GianMarcosBoaretto/moinho-mqtt/GUIA.md

# Guia de uso e de teste

Passo a passo para rodar o protótipo, usar o dashboard e testar cada requisito da entrega.
Também mostra como usar um **celular como nó transmissor** (seção 10) e o **painel de
tráfego** do dashboard, que mostra cada requisição e mensagem (seção 11).
Para o porquê das decisões, veja o [README](README.md) e a pasta [docs/](docs/).

## 1. O que você precisa

Escolha **um** dos dois jeitos:

| Jeito | Precisa de | Quando usar |
|---|---|---|
| **A. Docker** | Docker Desktop | é o jeito oficial da entrega; usa o Mosquitto de verdade e roda o teste automatizado |
| **B. Sem Docker (Windows)** | só Python 3.12 | máquina sem Docker; usa um broker MQTT em Python no lugar do Mosquitto |

Todos os comandos abaixo rodam na pasta do projeto (`moinho-mqtt`).

## 2. Como rodar

### Jeito A — Docker

Na primeira vez, crie o arquivo de senhas (`.env`, que não vai para o Git):

```bash
python scripts/preparar_segredos.py
```

Depois:

```bash
docker compose up --build
```

Espere aparecer `[MQTT] conectado ao broker` nos logs e abra <http://localhost:8085>.
Para parar: `Ctrl+C`, ou `docker compose down` em outro terminal.

### Jeito B — sem Docker (Windows)

```powershell
powershell -ExecutionPolicy Bypass -File scripts\rodar-local.ps1
```

Na primeira vez ele cria o ambiente Python (`.venv`) e instala as dependências, o que
leva cerca de 1 minuto. Depois abre **três janelas** e o navegador no dashboard:

| Janela | O que é | O que aparece nela |
|---|---|---|
| `BROKER MQTT` | o "correio" das mensagens | conexões dos clientes |
| `BACKEND` | o supervisório (recebe, grava, serve o dashboard) | `[RX]` a cada leitura recebida |
| `SIMULADOR` | o nó de medição (faz o papel do ESP32) | `[PROTECAO]`, `[MQTT]`, `[BUFFER]` |

Para parar tudo, feche as três janelas.

## 3. Usando o dashboard

Abra <http://localhost:8085>. A tela atualiza sozinha a cada 1 segundo.

| Parte da tela | O que mostra |
|---|---|
| Topo, à direita | `broker: conectado · nó: online` — situação da comunicação |
| **Corrente** | último valor medido, com "medido às HH:MM:SS" e o atraso de entrega (skew) |
| **Estado do nó** | `OPERANDO` (verde), `DESARMADO` ou `EMERGENCIA` (vermelho), com o motivo |
| **Último alarme** | último desarme/rearme e a hora em que aconteceu |
| **Consistência** | leituras gravadas, duplicadas descartadas, inválidas e lacunas de `seq` |
| **Gráfico** | últimos 3 min: azul = tempo real, laranja = chegou atrasado do buffer, tracejado = limite de 100 A |
| **Eventos** | desarmes, rearmes, emergências e nó online/offline |

Quando a comunicação cai, aparece um **banner vermelho** no topo. Nesse momento a corrente
e o estado ficam **em cinza**, com "VALOR ANTIGO" ao lado, e o gráfico ganha uma faixa
"sem dados".

## 4. Comandando o simulador

O simulador aceita comandos que imitam o que aconteceria na bancada:

| Comando | Imita | O que deve acontecer |
|---|---|---|
| `sobrecorrente` | carga pesada no moinho (~128 A) | em ~0,3 s: **DESARMADO**, motivo sobrecorrente, corrente cai para ~0 |
| `normal` | carga volta ao normal (~72 A) | nada visível: o desarme fica **travado** até rearmar |
| `rearmar` | botão de rearme | volta a **OPERANDO**; se a causa ainda existir (carga alta, sensor em falha), o rearme é **recusado** |
| `emergencia` | apertar a botoeira | **EMERGENCIA**, motor para |
| `liberar` | soltar a botoeira | sai da emergência; se havia desarme, continua desarmado |
| `falha_sensor` | sensor rompido | **DESARMADO**, motivo falha de sensor; a corrente aparece como "falha" |

Como enviar:

- **Jeito A (Docker):**
  ```bash
  ./scripts/comando.sh sobrecorrente
  ```
- **Jeito B (sem Docker):**
  ```powershell
  powershell -ExecutionPolicy Bypass -File scripts\comando.ps1 sobrecorrente
  ```

O comando chega ao simulador por um arquivo, **sem passar pelo MQTT**. Por isso
funciona também com o broker fora do ar, que é justamente o teste mais importante.

Para voltar ao estado inicial depois de um teste, envie `normal`, `liberar` e `rearmar`.

## 5. Como ver que está transmitindo

São três lugares, um para cada etapa do caminho:

1. **No broker — a mensagem está passando.** Em outro terminal:
   ```powershell
   .\.venv\Scripts\python scripts\espiar.py
   ```
   Deve aparecer uma mensagem `fabrica/planta1/moinho01/corrente` por segundo, com o
   `seq` subindo de 1 em 1. O status `[retained]` aparece logo ao conectar.
   (No Docker: `docker exec moinho-broker mosquitto_sub -t 'fabrica/#' -v`.)
2. **No backend — foi recebida e gravada.** A janela `BACKEND` (ou
   `docker compose logs -f backend`) mostra:
   ```
   [RX] moinho01 seq=4000000015 77.1 A operando skew=1 ms (tempo real)
   ```
3. **No dashboard — foi usada.** "medido às" avança a cada segundo, "gravadas" sobe e o
   gráfico azul cresce para a direita.

A API também pode ser aberta direto no navegador:
<http://localhost:8085/api/estado> ·
<http://localhost:8085/api/historico> ·
<http://localhost:8085/api/eventos>.

## 6. Roteiro de teste manual

Faça na ordem. Cada teste diz o que fazer e o que tem que aparecer. Se aparecer, passou.

### T1 — Fluxo normal

| Faça | Resultado esperado |
|---|---|
| Suba o sistema e espere 10 s | dashboard com ~72 A, **OPERANDO**, topo "broker: conectado · nó: online", sem banner |
| Rode o `espiar.py` | uma mensagem `/corrente` por segundo, `seq` sequencial |

### T2 — Proteção com rede funcionando

| Faça | Resultado esperado |
|---|---|
| Envie `sobrecorrente` | **DESARMADO**, motivo sobrecorrente; corrente ~0 A; "Desarme" na tabela de eventos; pico acima da linha de 100 A no gráfico |
| Envie `rearmar` (sem enviar `normal` antes) | rearme **recusado**: continua DESARMADO, e o log do simulador diz "a causa do desarme continua" (igual à bancada, que não rearma com a corrente alta) |
| Envie `normal` e depois `rearmar` | **OPERANDO**, ~72 A, evento "Rearme" |

### T3 — Emergência e falha de sensor

| Faça | Resultado esperado |
|---|---|
| Envie `emergencia` | **EMERGENCIA**, corrente ~0 |
| Envie `rearmar` | **recusado**: o log do simulador diz "rearme recusado: botoeira pressionada" |
| Envie `liberar` e depois `rearmar` | volta a **OPERANDO** |
| Envie `falha_sensor` | **DESARMADO**, motivo falha de sensor, corrente "falha" |
| Envie `normal` e depois `rearmar` | volta a **OPERANDO** |

### T4 — Queda de comunicação (o teste principal)

| Faça | Resultado esperado |
|---|---|
| **Derrube o broker.** Jeito B: feche a janela `BROKER MQTT`. Jeito A: `docker stop moinho-broker` | log do simulador: "broker inacessivel ... A PROTECAO LOCAL CONTINUA ATUANDO" |
| Espere 6 s | **banner vermelho** "Comunicação perdida há Xs — último dado recebido às HH:MM:SS"; valores **em cinza** com "VALOR ANTIGO"; topo "broker: DESCONECTADO"; faixa "sem dados" no gráfico |
| Com o broker ainda fora, envie `sobrecorrente` | **o simulador desarma mesmo sem rede**. O log mostra `estado=desarmado motivo=sobrecorrente ... (decidido localmente, SEM REDE)`. O dashboard **ainda mostra OPERANDO em cinza**, porque o dado não chegou, e o banner avisa disso |
| Espere 15 s | o log do simulador repete a cada 5 s: "sem broker ha Xs - protecao local ATIVA ... buffer N/300" |

### T5 — Volta da comunicação e reconstrução do histórico

| Faça | Resultado esperado |
|---|---|
| **Religue o broker.** Jeito B: `powershell -ExecutionPolicy Bypass -File scripts\rodar-local.ps1 -SoBroker`. Jeito A: `docker start moinho-broker` | log do simulador: "conectado ao broker (ficou fora Xs); buffer com N mensagens" e "[BUFFER] flush: N mensagens reenviadas" |
| Olhe o dashboard | banner some; **DESARMADO / sobrecorrente**; o trecho da falha aparece **em laranja** no gráfico; o desarme está nos eventos com a **hora em que aconteceu** (durante a falha), e não com a hora em que chegou; "lacunas de seq: 0" |
| Olhe a janela `BACKEND` | linhas `[RX] ... skew=12000 ms (BUFFER)` e depois `[RECUPERADO] ... lacunas restantes: 0` |
| Envie `normal` e `rearmar` | volta a **OPERANDO** |

### T6 — Duplicados são descartados

O reenvio do buffer normalmente não gera duplicado. Para provar que o backend descarta,
reenvie de propósito uma leitura que já foi gravada:

- **Jeito A:** o `teste_falha.sh` faz isso sozinho na etapa 5 (ver a seção 7).
- **Jeito B:**
  ```powershell
  .\.venv\Scripts\python -c "import json,urllib.request as u,paho.mqtt.publish as p; l=json.load(u.urlopen('http://localhost:8085/api/historico'))[-3]; m=json.dumps(dict(schema=1,device_id='moinho01',**{k:l[k] for k in ('seq','ts_origem','corrente_a','estado','motivo')})); [p.single('fabrica/planta1/moinho01/corrente',m,qos=1) for _ in range(2)]; print('reenviado seq',l['seq'])"
  ```

**Resultado esperado:** a janela `BACKEND` mostra duas linhas
`[DUP] moinho01 seq=... ja gravado -> descartado`, e no dashboard "duplicadas
descartadas" sobe 2. O histórico **não** ganha ponto novo.

### T7 — Buffer cheio (opcional, demora 5 min)

| Faça | Resultado esperado |
|---|---|
| Derrube o broker e espere **mais de 5 min** | log do simulador: "[BUFFER] cheio (300): descartando a mais antiga seq=..." |
| Religue o broker | dashboard mostra "lacunas de seq: 1 (N amostras)": o que passou de 5 min se perdeu, e o sistema **avisa** em vez de esconder |

## 7. Teste automatizado

Sem Docker (Windows), com o `rodar-local` fechado:

```powershell
powershell -ExecutionPolicy Bypass -File scripts\teste_falha_local.ps1
```

Ele sobe tudo sozinho em segundo plano, com banco próprio, executa T1, T4, T5 e T6 e
grava o resultado em `logs\local-<data-hora>\resultado.txt`. Leva cerca de 1 minuto.

Com Docker:

```bash
./scripts/teste_falha.sh
```

Ele executa T1, T4, T5 e T6 sozinho, em cerca de 1 min 30 s. Com o dashboard aberto ao
lado, tire um print a cada `>>> PRINT:` que aparecer no terminal. No final ele mostra
`RESULTADO: todas as verificacoes passaram` e salva logs e JSON em `logs/<data-hora>/`.
O que cada print precisa mostrar está em [EVIDENCIAS.md](EVIDENCIAS.md).

## 8. Com o ESP32 de verdade

A montagem segue o material da aula em `docs/bancada/` (diagrama de ligação, diagrama do relé
e passo a passo). Primeiro monte e teste com o código da **fase 1**,
`firmware/g2_moinho_teste/g2_moinho_teste.ino`, que não usa rede. Depois grave o firmware do grupo:

1. Na Arduino IDE, instale as bibliotecas **MQTT** (Joel Gaehwiler) e **ArduinoJson**.
2. Ligue o jumper do **GPIO27 ao GND**. Sem ele, o firmware entende que a emergência está
   apertada e mantém o motor parado.
3. Em `firmware/moinho01/`, ajuste o `config.h`: nome da rede Wi-Fi e `MQTT_HOST` com o
   **IP do PC** (`ipconfig`). Copie `secrets.exemplo.h` para `secrets.h` e preencha a senha do
   Wi-Fi e a `MQTT_SENHA` (o valor de `MQTT_SENHA_NO` no `.env` do PC).
4. No PC, suba sem o simulador, que usa o mesmo nome do ESP32:
   ```powershell
   powershell -ExecutionPolicy Bypass -File scripts\rodar-local.ps1 -SemSimulador
   ```
5. Grave na placa (*ESP32 Dev Module*) e abra o Monitor Serial em 115200.
6. Os testes são os mesmos da seção 6, trocando os comandos pela bancada:

| Comando do simulador | Na bancada | LEDs |
|---|---|---|
| `sobrecorrente` | girar o potenciômetro acima de ~2/3 do curso (> 100 A) | vermelho |
| `normal` | voltar o potenciômetro | continua vermelho até rearmar |
| `rearmar` | apertar o rearme (GPIO 14) por meio segundo, **com a corrente baixa** | verde |
| `emergencia` / `liberar` | tirar / recolocar o jumper do GPIO27 | vermelho / volta ao estado anterior |
| `falha_sensor` | girar o potenciômetro até o fim do curso (leitura saturada) | vermelho |
| derrubar o broker | fechar a janela do broker, ou desligar o Wi-Fi | não mudam: a proteção é local |

No T4, a prova mais forte: com o broker desligado, gire o potenciômetro. **O relé tem que
abrir**, o LED vermelho acende e o Monitor Serial mostra "SEM REDE". O ESP32 só conecta em
rede 2,4 GHz sem página de login; o mais simples é rotear a internet do celular.

> No PC, o Firewall do Windows pode bloquear a porta 1883 para a placa. Se o ESP32 não
> conectar, libere a porta 1883 (TCP) na rede privada.

## 9. Problemas comuns

| Sintoma | Causa provável | O que fazer |
|---|---|---|
| Dashboard abre mas fica "Nenhum dado recebido do nó ainda" | simulador não está rodando ou não achou o broker | veja a janela `SIMULADOR`; se diz "conectando" sem "conectado", o broker está fora |
| Simulador conecta e desconecta a cada ~3 s | **dois simuladores** abertos com o mesmo `client_id` (o broker derruba o mais antigo) | feche as janelas repetidas e deixe um só |
| `error while attempting to bind on address ... 8085` | já tem um backend rodando na porta 8085 | feche a janela `BACKEND` antiga |
| `rodar-local.ps1 não pode ser carregado ... execução de scripts desabilitada` | política de execução do Windows | rode com `powershell -ExecutionPolicy Bypass -File ...`, como neste guia |
| Banner fica vermelho com o broker no ar | relógio do PC errado, ou o backend não reconectou | confira `broker` no topo do dashboard; se estiver "DESCONECTADO", reinicie o backend |
| Quero recomeçar do zero | — | feche tudo e apague `backend/moinho.db` e a pasta `simulador/estado/`. No Docker: `docker compose down -v` |
| Celular não abre a página `/celular` | celular em outra rede, ou firewall bloqueando a porta 8085 | confira se o celular está no **mesmo Wi-Fi** do PC; libere o Python (ou a porta 8085 TCP) no Firewall do Windows |
| Celular abre a página mas para de transmitir | tela apagou: o navegador do celular congela a página em segundo plano | deixe a tela ligada e o navegador em primeiro plano durante a demonstração |

## 10. Celular como nó transmissor

Um celular pode fazer o papel do ESP32. A página `/celular` roda **no navegador do
celular** a mesma lógica do nó: proteção local a cada 100 ms, buffer circular de 300 e o
mesmo payload. O celular **é o moinho01**: faz o papel do simulador. Por isso o
simulador do PC precisa estar **desligado**; se os dois publicarem como `moinho01`, a
página do celular mostra um aviso vermelho.

### Como abrir

1. PC e celular na **mesma rede Wi-Fi**.
2. Suba o sistema **sem o simulador**:
   - jeito B: `powershell -ExecutionPolicy Bypass -File scripts\rodar-local.ps1 -SemSimulador`
     (ele já escuta na rede);
   - jeito A: `docker compose up --build broker backend`.
3. No topo do dashboard aparece "📱 no celular, abra **http://IP-DO-PC:8085/celular**".
   Digite esse endereço no navegador do celular. Na primeira vez ele pede a **chave de
   acesso**: é o valor de `GATEWAY_TOKEN` no arquivo `.env` do PC. Sem ela, o PC recusa os
   envios (HTTP 401), e as leituras ficam guardadas no celular até a chave certa.
4. Abra `localhost:8085` no PC. O dashboard mostra o **moinho01**, que agora é o seu
   celular: mexa na carga no celular e veja a corrente mudar no PC. A faixa
   **Dispositivos**, no topo, mostra todos os dispositivos ao vivo; clique num deles para
   trocar.

### O caminho do dado

```
celular ──HTTP POST /api/gateway/corrente──▶ backend (ponte) ──MQTT QoS 1──▶ broker ──▶ assinante ──▶ SQLite ──▶ dashboard
   ▲                                              │
   └────── resposta 200 + GET /api/gateway/situacao ("o PC gravou até o seq X")
```

O navegador do celular não fala MQTT puro, só HTTP. Por isso o backend recebe a leitura
por HTTP e **publica no broker** no tópico `fabrica/planta1/moinho01/corrente`, igual a
um ESP32. Dali em diante o caminho é o mesmo do simulador. O celular **envia** a leitura e
**recebe** de volta a confirmação: a resposta do POST e, a cada 2 s, quantas leituras o PC
já gravou, o último `seq` e o atraso.

### O que dá para fazer na tela do celular

| Controle | Faz o papel de | Resultado |
|---|---|---|
| Controle deslizante "Carga do moinho" | potenciômetro | acima de 100 A por 0,3 s: **DESARMADO · sobrecorrente** |
| 🛑 Emergência | botoeira (liga/desliga) | **EMERGENCIA**, motor para |
| ↺ Rearmar | botão de rearme | volta a OPERANDO, se a causa sumiu e a emergência foi solta |
| ⚡ Falha de sensor | sensor rompido (liga/desliga) | **DESARMADO · falha de sensor** |
| 📵 Simular queda | cortar a comunicação | nada sai do celular; as leituras vão para o buffer |

O "Log de envio e resposta" mostra cada requisição: `→ POST corrente seq …0042 72.1 A ← 200 · 4 ms`.

### Teste de queda pelo celular

1. Toque **📵 Simular queda**. Em 5 s o dashboard mostra o banner de
   comunicação perdida.
2. Arraste a carga para **130 A**. O celular desarma **sozinho**, e o log diz "decidido no
   celular, SEM REDE". O contador "no buffer" sobe.
3. Volte a carga para ~72 A e toque **📵 Simular queda** de novo. O log mostra "flush do
   buffer: N mensagens reenviadas", e o celular exibe "PC confirmou: ... lacunas 0".
4. No dashboard, o desarme aparece nos eventos com a hora em que aconteceu no celular.
5. Toque **↺ Rearmar**.

Também vale desligar o Wi-Fi do celular de verdade. Com o Wi-Fi desligado a página
continua aberta e protegendo, e reenvia tudo quando a rede volta. Recarregar a página
apaga o buffer, porque ele fica na memória do navegador. As mensagens que estavam nele
viram lacuna de `seq`, e o dashboard mostra isso.

## 11. Painel de tráfego (o "Wireshark" do dashboard)

À direita do dashboard fica o painel **Tráfego**. Ele mostra, ao vivo, cada mensagem que
o backend enviou ou recebeu, com a mais nova em cima:

| Tipo | Exemplo | Significa |
|---|---|---|
| `HTTP` | `192.168.1.40 → backend :8085` · `POST /api/gateway/corrente -> 200 · 4 ms` | requisição que chegou na API: quem pediu (IP), o quê, status e tempo de resposta |
| `MQTT` ⇢ (TX) | `supervisorio-planta1 (ponte HTTP) ⇢ broker` · `PUBLISH fabrica/planta1/moinho01/corrente QoS1` | o backend publicou no broker (ponte do celular) |
| `MQTT` ⇠ (RX) | `moinho01 (via broker) ⇠ supervisorio-planta1` · `PUBLISH fabrica/planta1/moinho01/corrente QoS1` | mensagem que o broker entregou ao assinante |
| `MQTT` ⇄ | `CONNECT ok` / `conexao PERDIDA` | o backend conectou ou perdeu o broker |

- **Clique numa linha** para abrir o conteúdo: payload JSON, tópico, QoS, retained,
  corpo enviado e resposta do HTTP, IP e navegador de quem chamou.
- Uma **barra laranja à esquerda** marca o que veio do celular.
- Uma **linha vermelha** é erro HTTP (ex.: `503` com o broker fora, `422` com payload inválido).
- **Filtros:** HTTP, MQTT e **ocultar polling**, ligado por padrão, que esconde as consultas
  que o próprio dashboard e o celular fazem a cada 1–2 s. **Pausar** congela a lista para
  ler com calma; **limpar** esvazia.

Uma leitura do celular aparece no painel como **três linhas**, na ordem: o `POST` (HTTP), o
`PUBLISH` da ponte (MQTT ⇢) e o `PUBLISH` entregue pelo broker (MQTT ⇠). É o caminho
inteiro do dado, visível. Bom para print.

> Não é captura de pacotes de rede como o Wireshark de verdade: o painel mostra o que
> passou **pelo backend**. Mensagens que o broker trocou só com outros clientes, e os
> pacotes de controle do MQTT (PUBACK, PINGREQ), não aparecem. Para ver os pacotes
> crus, use o Wireshark com o filtro `tcp.port == 1883 || tcp.port == 8085`.

## 12. Testes de tolerância a falhas e segurança

Detalhes e justificativas em [docs/TOLERANCIA_E_SEGURANCA.md](docs/TOLERANCIA_E_SEGURANCA.md).
Suba o sistema com `scripts\rodar-local.ps1` e deixe o dashboard aberto.

### Automático (tudo de uma vez)

Com o `rodar-local` fechado:

```powershell
powershell -ExecutionPolicy Bypass -File scripts\teste_falha_local.ps1
```

Faz as falhas de comunicação e de origem e os testes de segurança, e confere 25 itens em
cerca de 1 min 30 s. No final: `RESULTADO: todas as verificacoes passaram`.

### T8 — Falha da origem (o simulador para)

| Faça | Resultado esperado |
|---|---|
| Feche a janela `SIMULADOR` | em 5 s: aviso "Comunicação perdida há X s — último dado recebido às HH:MM:SS", valor em cinza ("VALOR ANTIGO"), nó **offline** |
| Religue: `powershell -ExecutionPolicy Bypass -File scripts\rodar-local.ps1 -SoSimulador` | o aviso some sozinho; nos eventos aparecem "⚠ Dados pararam" e "✔ Dados voltaram (X s sem dados)" |

(A falha de **comunicação** é o T4/T5: feche `BROKER MQTT` e religue com `-SoBroker`.)

### T9 — Log de quando os dados pararam e voltaram

```powershell
Select-String -Path logs\supervisorio.log -Pattern 'SEM DADOS|DADOS VOLTARAM'
```

Deve mostrar uma linha `[SEM DADOS]` e uma `[DADOS VOLTARAM]` (com a duração) para cada falha.

### T10 — Segurança

| Teste | Comando | Resultado esperado |
|---|---|---|
| Broker sem senha | `.\.venv\Scripts\python scripts\espiar.py --sem-senha` | `RECUSADO pelo broker: Not authorized` |
| Broker com senha | `.\.venv\Scripts\python scripts\espiar.py` | conecta e mostra as mensagens (usa a senha do `.env`) |
| API sem chave | `curl.exe -i -X POST http://localhost:8085/api/gateway/corrente -d '{}'` | `HTTP/1.1 401 Unauthorized`; no painel de tráfego, linha vermelha; no log, `[SEGURANCA] ... RECUSADO` |
| Senhas fora do Git | `git ls-files .env mosquitto/senhas-amqtt.txt firmware/moinho01/secrets.h` | não imprime nada |
