GianMarcosBoaretto/moinho-mqtt/docs/bancada/diagrama-de-ligacao.png

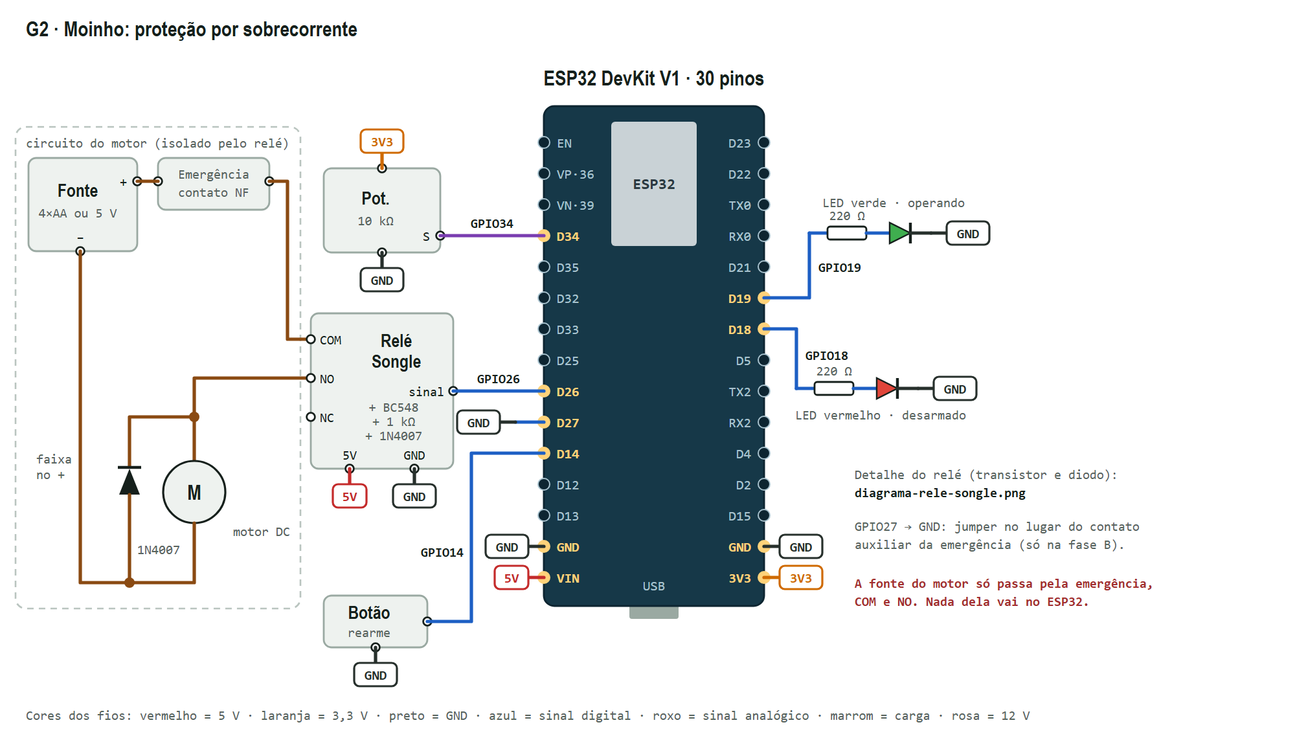
docs/bancada/diagrama-de-ligacao.png
