GianMarcosBoaretto/moinho-mqtt/docs/bancada/diagrama-rele-songle.png

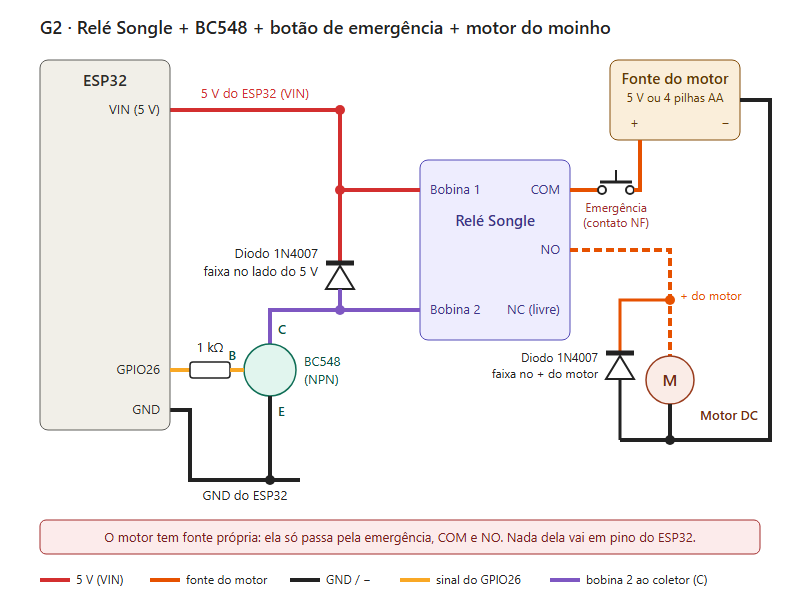
docs/bancada/diagrama-rele-songle.png
