GianMarcosBoaretto/moinho-mqtt/firmware/moinho01/secrets.exemplo.h

// Modelo dos segredos do no. Copie para secrets.h (que NAO vai para o Git) e preencha.
//   - WIFI_SENHA: senha da rede Wi-Fi da bancada
//   - MQTT_SENHA: o valor de MQTT_SENHA_NO do arquivo .env do PC
#pragma once

#define WIFI_SENHA  "senha-do-wifi"
#define MQTT_SENHA  "valor-de-MQTT_SENHA_NO-no-.env"
