GianMarcosBoaretto/moinho-mqtt/(commit log)

2026-10-13 Simulador do no de medicao (protecao local + telemetria MQTT)
    Protecao decide e atua a cada 100 ms sem tocar em rede; a telemetria vai
    para um buffer circular de 300 amostras, esvaziado com QoS 1 quando ha
    broker. LWT e status retained. seq por bloco de boot para nao colidir
    apos reinicio.
2026-10-13 Backend supervisorio e dashboard
    Backend: assina fabrica/+/+/{corrente,alarme,status} com QoS 1 e sessao
    persistente, valida o schema, grava ts_recebimento e skew, descarta
    duplicados por UNIQUE(device_id, seq), calcula lacunas de seq e expoe
    /api/estado, /api/historico e /api/eventos ordenados por ts_origem.
    Dashboard (HTML puro, polling de 1 s): corrente, estado, ultimo alarme,
    historico e banner de comunicacao perdida com valores em cinza.
2026-10-13 Firmware ESP32 com a mesma logica e o mesmo contrato do simulador
    Protecao numa tarefa FreeRTOS de prioridade maior que o loop(): mede,
    decide e aciona o rele sem tocar em rede. O loop() faz o monitoramento:
    fila -> buffer circular de 300 -> publish QoS 1 (arduino-mqtt), LWT,
    status retained, ts_origem via NTP reconstruido do relogio monotonico.
2026-10-13 Script de teste de falha de comunicacao (docker stop/start do broker)
    Verifica desarme local sem rede, STALE no backend, reconstrucao do
    historico sem lacunas e descarte de duplicados; salva logs e JSON por
    etapa em logs/<data-hora>/ e indica onde tirar os prints.
2026-10-13 Documentacao: nomeacao, sincronizacao, falha de comunicacao, decisoes e arquitetura
2026-10-13 README e EVIDENCIAS com roteiro de prints e execucao de referencia
2026-10-14 Guia de uso e teste + scripts para rodar sem Docker no Windows
    rodar-local.ps1 sobe broker (amqtt), backend e simulador em janelas
    separadas; comando.ps1 comanda o simulador; espiar.py mostra o trafego
    MQTT. GUIA.md traz o roteiro de teste manual T1-T7.
2026-10-14 Backend: ponte HTTP->MQTT para o celular e captura de trafego
    POST /api/gateway/{corrente,alarme,status} valida o payload e publica no
    broker com QoS 1 (503 com o broker fora, para o celular manter o buffer).
    MonitorTrafego guarda as ultimas 600 mensagens HTTP e MQTT em memoria e
    /api/trafego as entrega ao painel do dashboard.
2026-10-14 Dashboard: painel de trafego estilo Wireshark e seletor de dispositivo
2026-10-14 Pagina /celular: celular como no transmissor (celular01)
    Mesma logica do no: protecao local a cada 100 ms, buffer de 300, seq por
    boot e queda simulada. Envia por HTTP e mostra a confirmacao do PC.
2026-10-14 Docs: celular como no, painel de trafego e ponte HTTP->MQTT
2026-10-14 Dashboard mostra o celular sem precisar procurar
    Faixa de dispositivos ao vivo no topo (/api/resumo), troca automatica para
    um dispositivo novo que comeca a transmitir e, sem ?device=, abre no
    celular se ele estiver transmitindo.
2026-10-14 Celular passa a ser o moinho01 (no lugar do simulador)
    Pagina /celular publica como moinho01. O boot do seq e o minuto desde
    2026, para nao colidir com os blocos pequenos do simulador no mesmo
    device_id; a pagina avisa se outra fonte publica como moinho01 ao mesmo
    tempo. rodar-local.ps1 ganhou -SemSimulador.
2026-10-14 Porta do backend passa de 8000 para 8085
    A 8000 colidia com outro servico da maquina de desenvolvimento. O
    endereco do celular e o rotulo do painel agora usam a porta da propria
    requisicao, sem numero fixo.
2026-10-14 Teste de falha sem Docker e evidencias registradas
    teste_falha_local.ps1 repete o roteiro do teste_falha.sh no Windows.
    Execucao de 14/10/2026: 14 de 14 verificacoes aprovadas, com logs, JSON
    por etapa e prints do dashboard, do celular e do painel de trafego.
2026-10-19 PDF da entrega com documentação, decisões e evidências
    Reúne resumo, arquitetura, nomeação, sincronização, falha de comunicação,
    decisões e evidências com prints, para anexar à documentação do projeto.
2026-10-19 Documento do projeto v4 com a seção de comunicação e consistência
    Substitui o PDF avulso pelo documento do grupo atualizado: as páginas 4 a
    9 trazem o fluxo implementado, nomeação, sincronização, falha de
    comunicação, replicação, decisões e evidências.
2026-10-19 Documento v4: links clicáveis para o repositório e as evidências
2026-10-26 Tolerância a falhas e segurança: log de falha, senha no broker, token na API
    - supervisório registra em log (arquivo) e na tabela de eventos quando os
    dados param e quando voltam, com a duração; o dashboard mostra
    - broker sem acesso anônimo: usuário e senha por cliente (no-moinho01 e
    supervisorio) e ACL de tópicos (o nó só publica no próprio moinho)
    - API do celular exige token (Authorization: Bearer), comparado em tempo
    constante; o celular pede a chave se o PC recusar
    - senhas fora do código: .env gerado com valores aleatórios
    (scripts/preparar_segredos.py), secrets.h no firmware, ambos no .gitignore
    - teste_falha_local.ps1: para também a origem e confere segurança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
    [config.h, moinho01.ino, secrets.exemplo.h]
2026-10-26 Documentação de tolerância a falhas e segurança + documento v5
    - docs/TOLERANCIA_E_SEGURANCA.md responde aos cinco itens da atividade
    - documento do grupo v5: seção nova nas páginas 10 a 15, com prints da
    origem parada, da volta com os eventos e do acesso recusado (401)
    - GUIA e README: .env para o Docker e chave de acesso no celular
2026-10-26 Roteiro de teste de tolerância a falhas e segurança
    rodar-local.ps1 ganha -SoSimulador (religa só a origem, com a senha do
    .env); espiar.py entra com a senha do supervisório e, com --sem-senha,
    mostra a recusa do broker. GUIA seção 12 com os testes T8 a T10.
2026-11-11 Integra a bancada da aula 13 (G2 moinho) ao firmware do grupo
    - firmware/g2_moinho_teste: código da fase 1 da aula (bancada sem rede)
    - docs/bancada: diagrama de ligação, diagrama do relé e passo a passo
    - firmware moinho01: LEDs verde (GPIO19) e vermelho (GPIO18); mesma escala
    da fase 1 (curso todo = 0 a 150 A), com falha de sensor só na leitura
    saturada, para não desarmar com o potenciômetro no mínimo
    - rearme só com a causa resolvida (corrente abaixo do limite), como na
    fase 1; a mesma regra no simulador e na página do celular
    - README e GUIA: montagem em duas fases, jumper do GPIO27, secrets.h e
    rodar-local -SemSimulador
2026-11-11 Firmware: corrige erro de compilação no define da ArduinoJson
    O comentário na mesma linha de #define ARDUINOJSON_USE_LONG_LONG entrava
    na colagem de tokens que a ArduinoJson faz com o valor da macro e
    quebrava a compilação. O erro existia desde a primeira versão; aparece
    agora porque o firmware foi compilado pela primeira vez (arduino-cli,
    esp32 3.3.11, MQTT 2.5.3, ArduinoJson 7.4.3). Os dois sketches compilam
    sem erro nem aviso.
    [moinho01.ino]
